kantoniak/still-sao-though/hardware/still-sao-though.kicad_pcb

## KiCad design hardware/still-sao-though.kicad_pcb (2025-03-22)

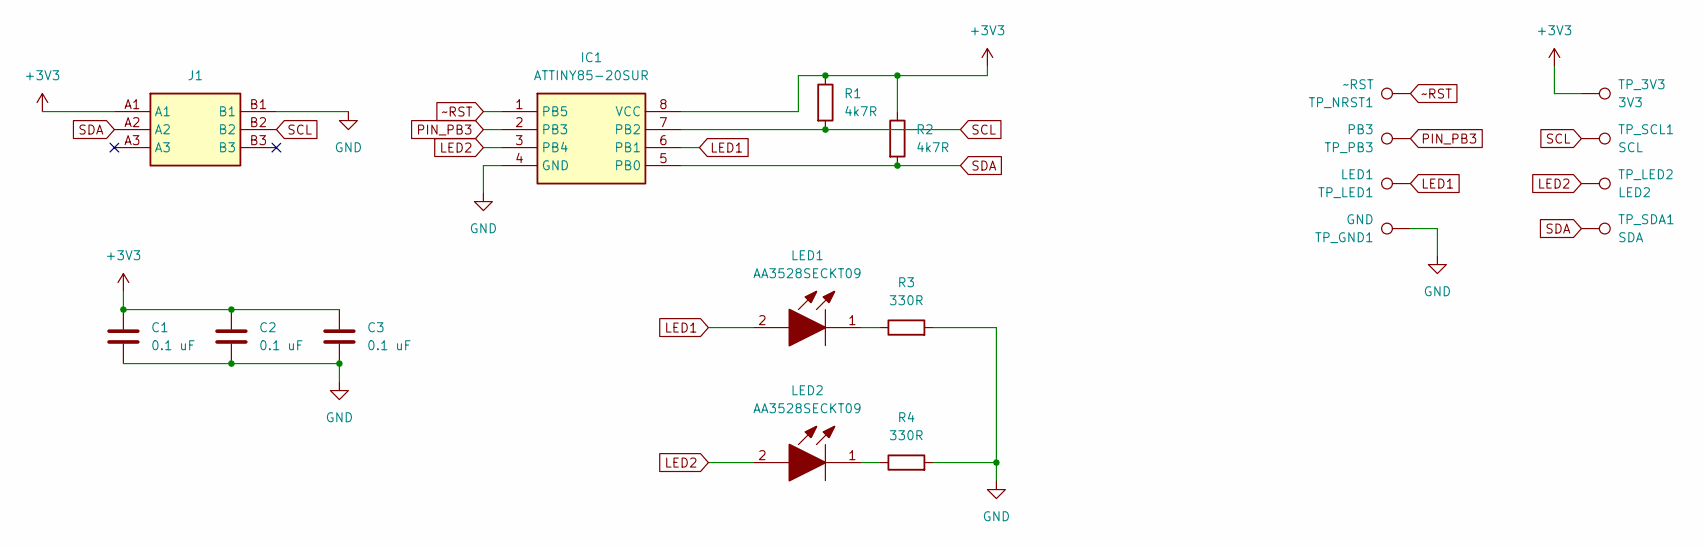
[picture p2: schematic still-sao-though.kicad_sch]

Parts:
C1, C2, C3: 0.1 uF; C_0603_1608Metric_Pad1.08x0.95mm_HandSolder
IC1: ATTINY85-20SUR; SOIC127P798X216-8N; Mouser Part Number 556-ATTINY85-20SUR
J1: 10129383-906002BLF; 10129383906002BLF; Manufacturer_Part_Number 10129383-906002BLF
LED1, LED2: AA3528SECKT09; Mouser Part Number 604-AA3528SECKT09
R1, R2: 4k7R; R_0603_1608Metric_Pad0.98x0.95mm_HandSolder
R3, R4: 330R; R_0603_1608Metric_Pad0.98x0.95mm_HandSolder
TP_3V3: 3V3; TestPoint_Pad_D1.0mm
TP_GND1: GND; TestPoint_Pad_D1.0mm
TP_LED1: LED1; TestPoint_Pad_D1.0mm
TP_LED2: LED2; TestPoint_Pad_D1.0mm
TP_NRST1: ~RST; TestPoint_Pad_D1.0mm
TP_PB3: PB3; TestPoint_Pad_D1.0mm
TP_SCL1: SCL; TestPoint_Pad_D1.0mm
TP_SDA1: SDA; TestPoint_Pad_D1.0mm

Connections:
+3V3: C1.1, C2.1, C3.1, IC1.8 (VCC), J1.A1, R1.1, R2.1, TP_3V3.1
GND: C1.2, C2.2, C3.2, IC1.4 (GND), J1.B1, R3.2, R4.2, TP_GND1.1
LED1: IC1.6 (PB1), LED1.2, TP_LED1.1
LED2: IC1.3 (PB4), LED2.2, TP_LED2.1
unnamed: LED1.1, R3.1
unnamed: LED2.1, R4.1
PIN_PB3: IC1.2 (PB3), TP_PB3.1
SCL: IC1.7 (PB2), J1.B2, R1.2, TP_SCL1.1
SDA: IC1.5 (PB0), J1.A2, R2.2, TP_SDA1.1
~RST: IC1.1 (PB5), TP_NRST1.1

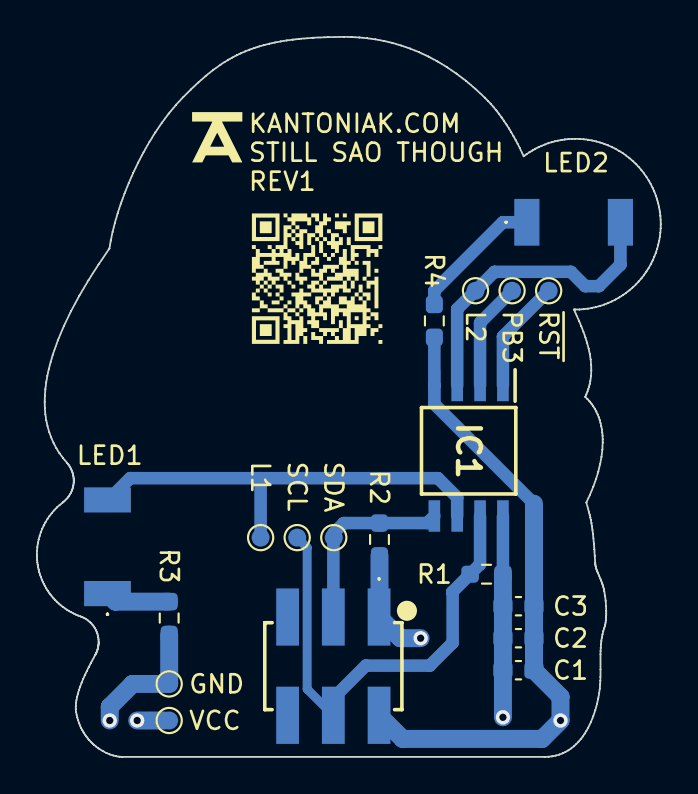
[picture p3: board still-sao-though.kicad_pcb from below]

Board: 4 copper layers, 34.7 x 40.0 mm, 19 parts (19 on the bottom side), 10 nets.
