kantoniak/still-sao-though/(commit log)

2025-03-22 Blink LEDs interchangeably
2025-03-22 Add hardware files
    [still-sao-though.kicad_pcb, still-sao-though.kicad_sch]
